Marcel-os/LWP/README.md

# Linefollower
Pliki związane z budową robota LF
