Marcel-os/LWP/schemat + pcb/PCB.png

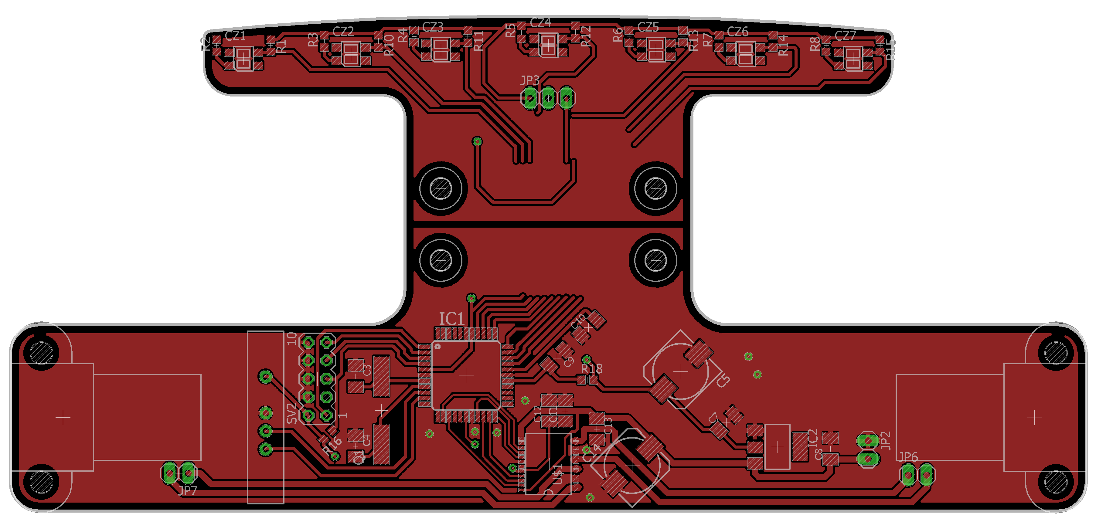
schemat + pcb/PCB.png
