Marcel-os/LWP/schemat + pcb/SCHEMAT.png

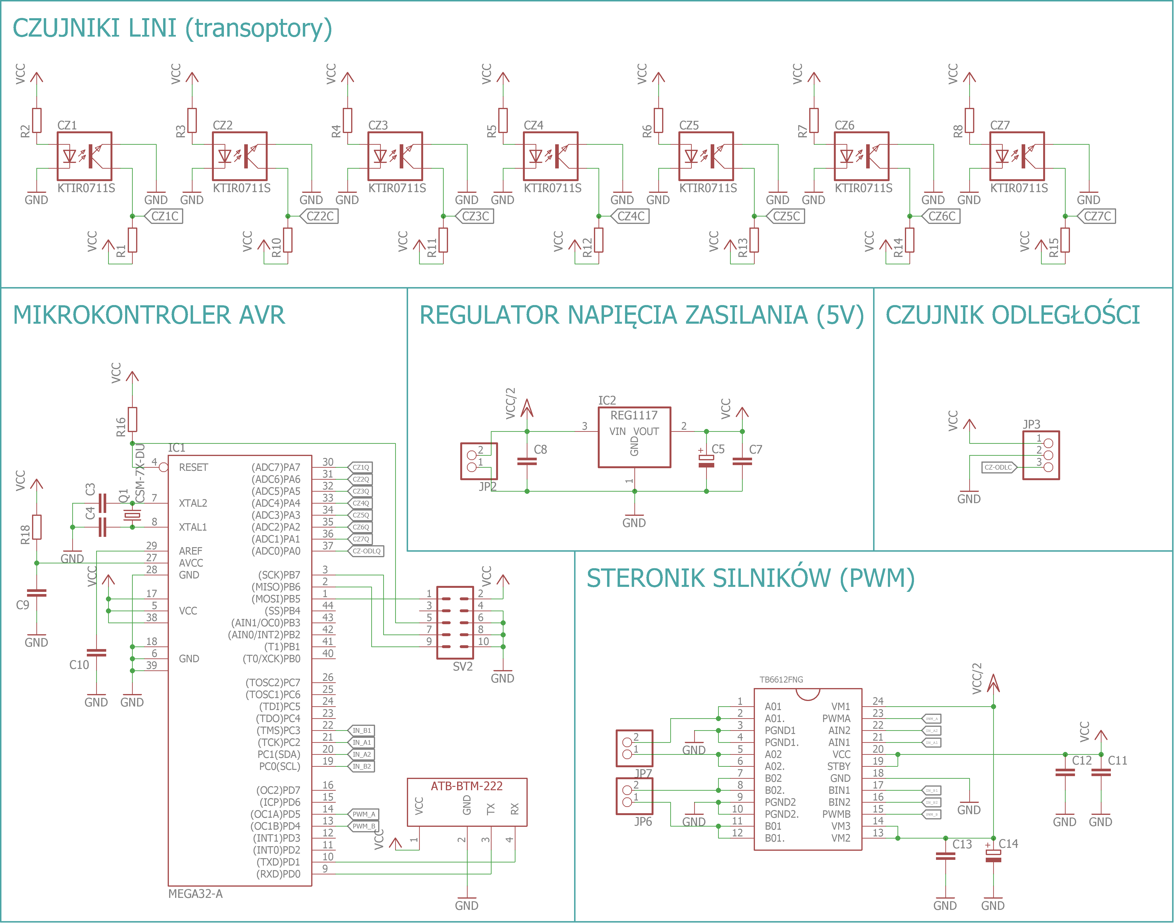
schemat + pcb/SCHEMAT.png
