Marcel-os/LWP/modele solid/kolo.SLDPRT

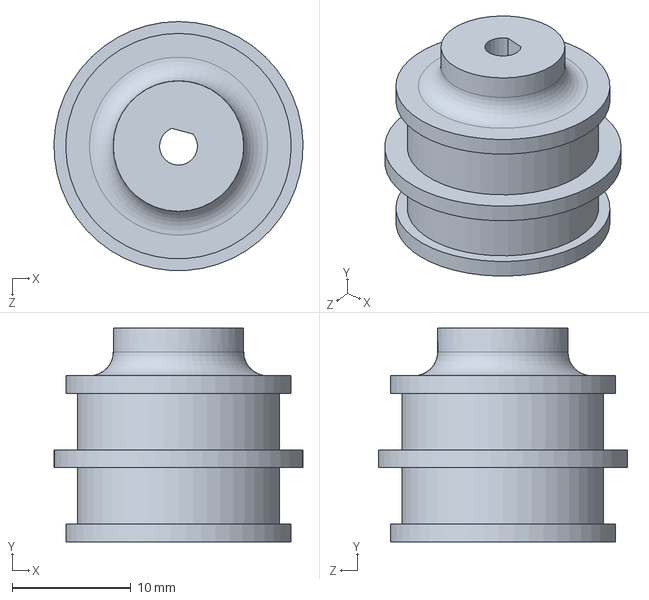
[picture p3: CAD file, 2020-06-14]
modele solid/kolo.SLDPRT
21.0 x 18.0 x 21.0 mm
