Marcel-os/LWP/modele stl/czesc.STL

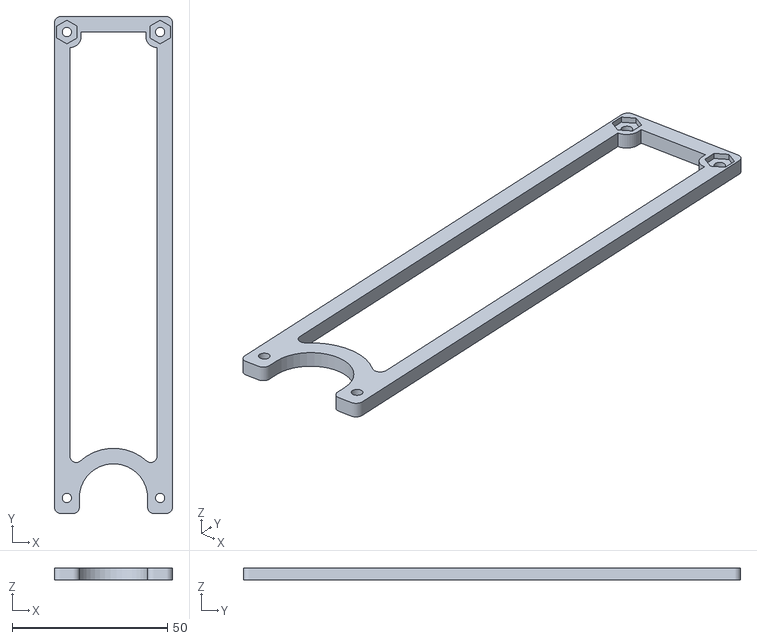
[picture p4: CAD file, 2020-06-14]
modele stl/czesc.STL
38.0 x 160.0 x 4.00
