Marcel-os/LWP/modele solid/lacznik2.SLDPRT

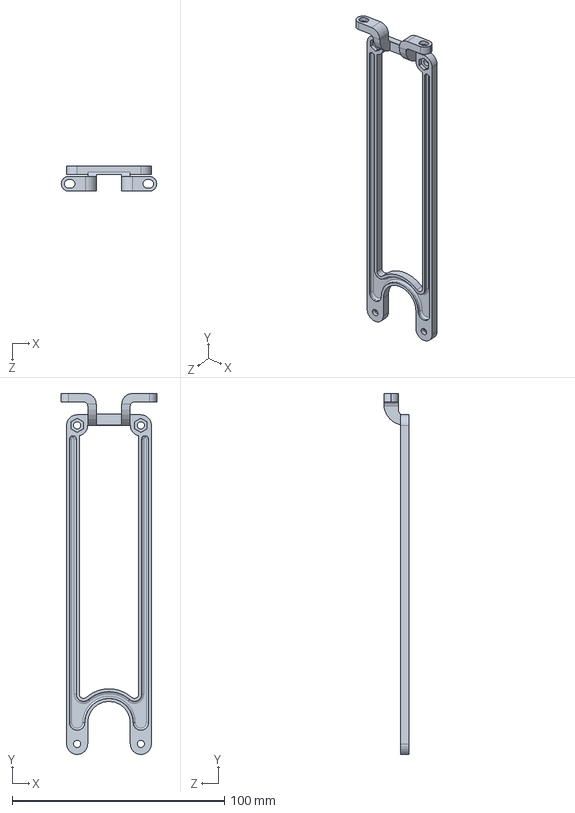
[picture p5: CAD file, 2020-06-14]
modele solid/lacznik2.SLDPRT
45.0 x 170.0 x 12.0 mm
