Marcel-os/LWP/modele stl/lf-hob.STL

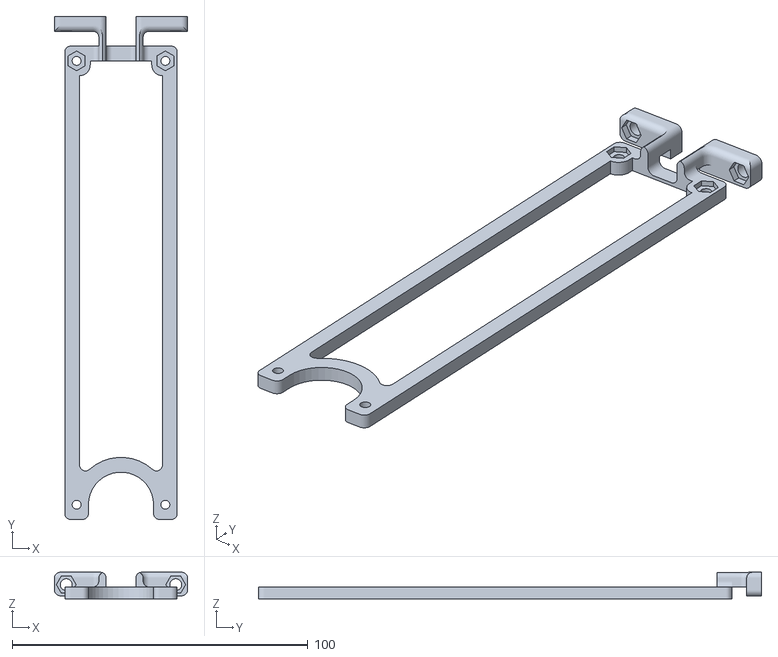
[picture p6: CAD file, 2020-06-14]
modele stl/lf-hob.STL
45.0 x 170.0 x 9.00
