Marcel-os/LWP/modele solid/czesc3.SLDPRT

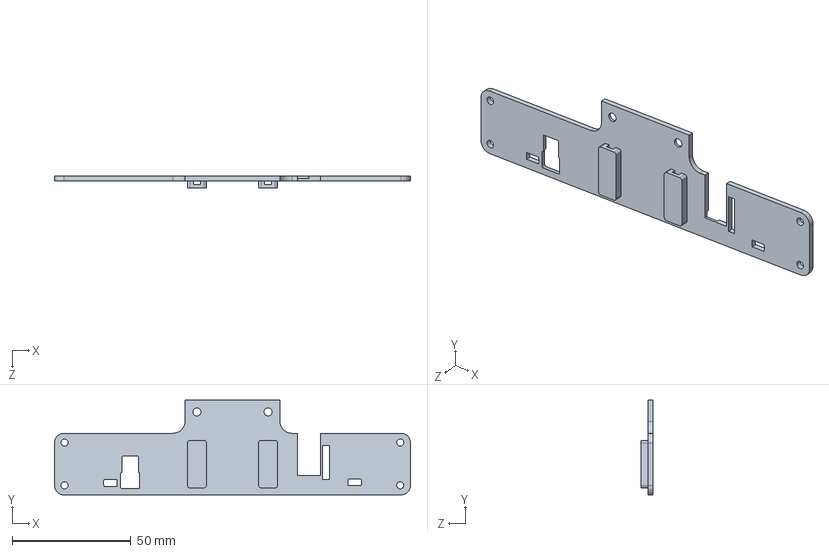
[picture p7: CAD file, 2020-06-14]
modele solid/czesc3.SLDPRT
150.0 x 40.0 x 5.00 mm
