Marcel-os/LWP/modele stl/proba1.STL

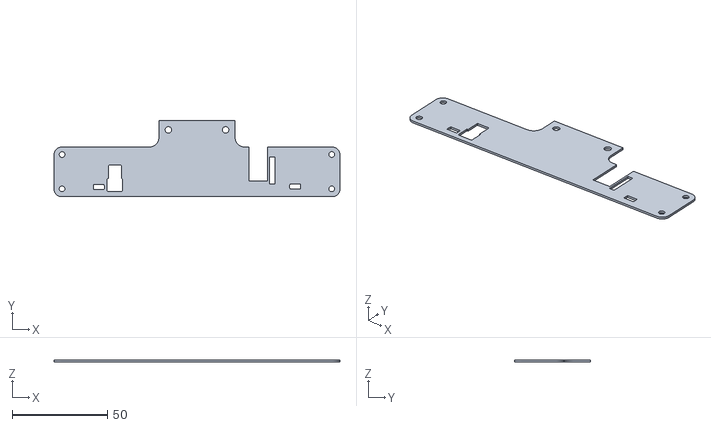
[picture p8: CAD file, 2020-06-14]
modele stl/proba1.STL
150.0 x 40.0 x 1.00
