Marcel-os/LWP/modele solid/PCB.dxf

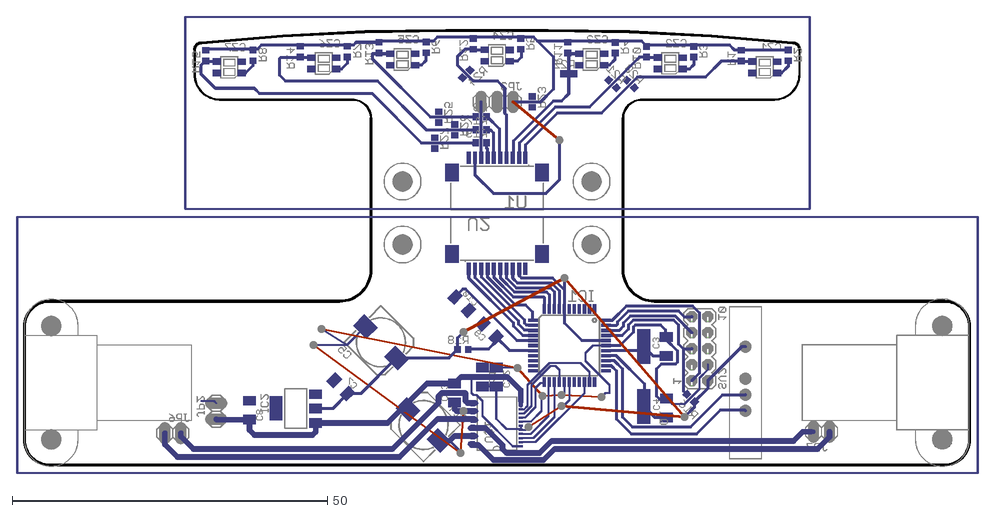
[picture p9: CAD file, 2020-06-14]
modele solid/PCB.dxf
152.7 x 72.7
