Marcel-os/LWP/(list of files, cad)

Other CAD files:
modele solid/czesc1.SLDPRT
