Marcel-os/LWP/schemat + pcb/untitled.brd

## EAGLE design schemat + pcb/untitled.brd (2020-04-21)

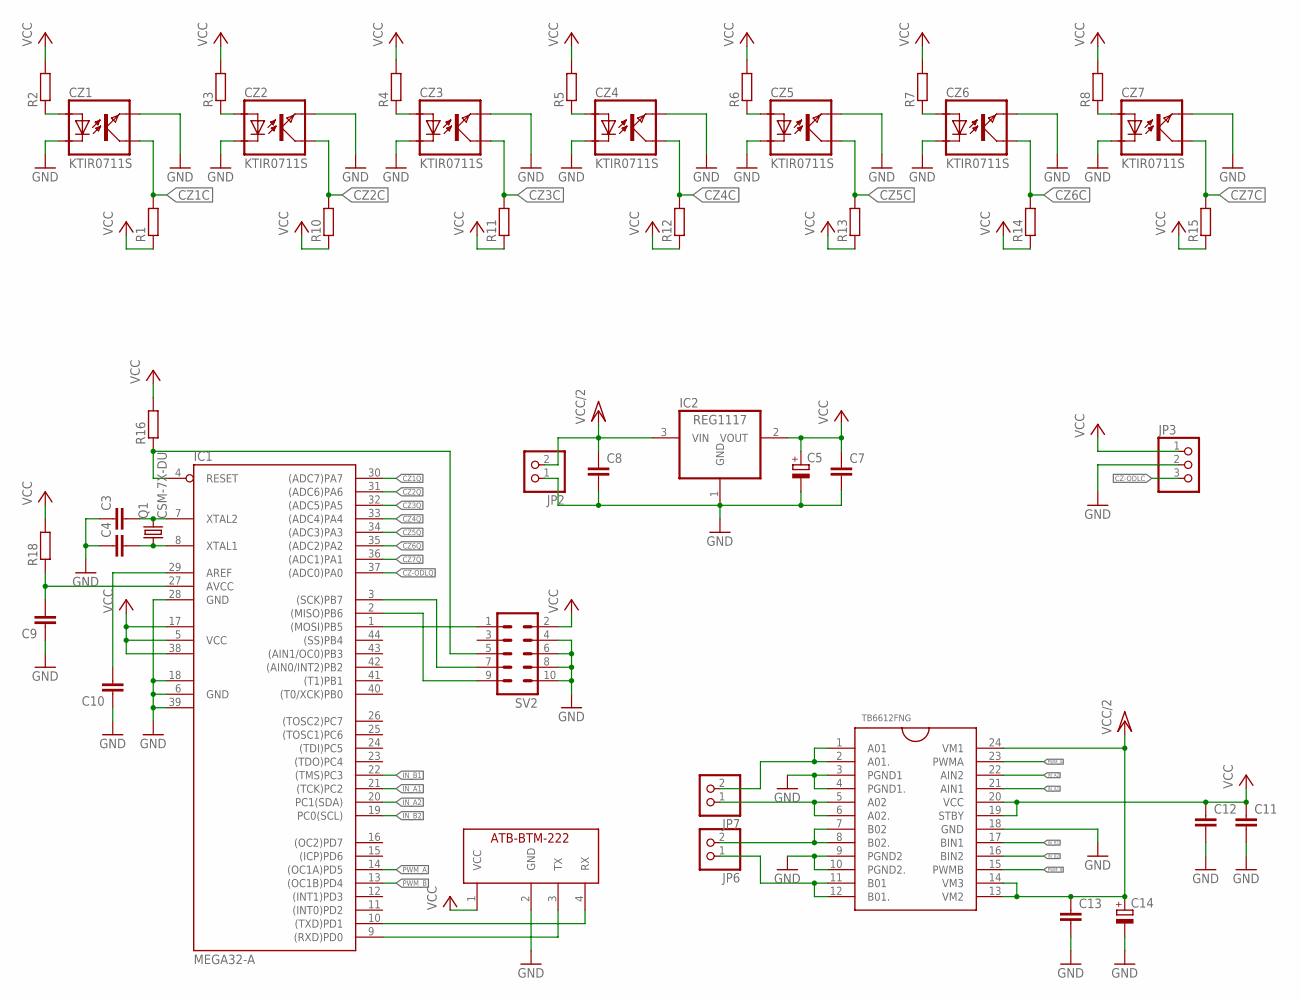
[picture p10: schematic untitled.sch]

Parts:
C3, C4, C7, C8, C9, C10, C11, C12, C13: C-EUC1206K; C1206K
C5, C14: CPOL-EU175TMP-0810; 175TMP-0810
CZ1, CZ2, CZ3, CZ4, CZ5, CZ6, CZ7: KTIR0711S; TOP
IC1: MEGA32-A; TQFP44
IC2: REG1117; SOT223
JP2, JP6, JP7: PINHD-1X2; 1X02
JP3: PINHD-1X3; 1X03
Q1: CSM-7X-DU
R1, R2, R3, R4, R5, R6, R7, R8, R10, R11, R12, R13, R14, R15, R16, R18: R-EU_R0603; R0603
SV2: MA05-2
U$1: TB6612FNG; SSOP24
U$2: ATB-BTM-222

Connections:
CZ1C: CZ1.KOLEKTOR, R1.2
CZ1Q: IC1.30 ((ADC7)PA7)
CZ2C: CZ2.KOLEKTOR, R10.2
CZ2Q: IC1.31 ((ADC6)PA6)
CZ3C: CZ3.KOLEKTOR, R11.2
CZ3Q: IC1.32 ((ADC5)PA5)
CZ4C: CZ4.KOLEKTOR, R12.2
CZ4Q: IC1.33 ((ADC4)PA4)
CZ5C: CZ5.KOLEKTOR, R13.2
CZ5Q: IC1.34 ((ADC3)PA3)
CZ6C: CZ6.KOLEKTOR, R14.2
CZ6Q: IC1.35 ((ADC2)PA2)
CZ7C: CZ7.KOLEKTOR, R15.2
CZ7Q: IC1.36 ((ADC1)PA1)
CZ-ODLC: JP3.3
CZ-ODLQ: IC1.37 ((ADC0)PA0)
GND: C3.1, C4.1, C5.-, C7.2, C8.2, C9.1, C10.1, C11.2, C12.2, C13.2, C14.-, CZ1.EMITER, CZ1.KATODA, CZ2.EMITER, CZ2.KATODA, CZ3.EMITER, CZ3.KATODA, CZ4.EMITER, CZ4.KATODA, CZ5.EMITER, CZ5.KATODA, CZ6.EMITER, CZ6.KATODA, CZ7.EMITER, CZ7.KATODA, IC1.6 (GND), IC1.18 (GND1), IC1.28 (GND), IC1.39 (GND2), IC2.1 (GND), JP2.1, JP3.2, SV2.4, SV2.6, SV2.8, SV2.10, U$1.3 (PGND1), U$1.4 (PGND1.), U$1.9 (PGND2), U$1.10 (PGND2.), U$1.18 (GND), U$2.2 (GND)
IN_A1: IC1.21 ((TCK)PC2), U$1.21 (AIN1)
IN_A2: IC1.20 (PC1(SDA)), U$1.22 (AIN2)
IN_B1: IC1.22 ((TMS)PC3), U$1.17 (BIN1)
IN_B2: IC1.19 (PC0(SCL)), U$1.16 (BIN2)
unnamed: IC1.10 ((TXD)PD1), U$2.4 (RX)
unnamed: IC1.9 ((RXD)PD0), U$2.3 (TX)
unnamed: C9.2, IC1.27 (AVCC), R18.1
unnamed: C10.2, IC1.29 (AREF)
unnamed: IC1.1 ((MOSI)PB5), SV2.1
unnamed: IC1.3 ((SCK)PB7), SV2.7
unnamed: IC1.2 ((MISO)PB6), SV2.9
unnamed: IC1.4 (RESET), R16.1, SV2.5
unnamed: C3.2, IC1.7 (XTAL2), Q1.2
unnamed: C4.2, IC1.8 (XTAL1), Q1.1
unnamed: CZ1.ANODA, R2.1
unnamed: CZ2.ANODA, R3.1
unnamed: JP6.2, U$1.7 (B02), U$1.8 (B02.)
unnamed: JP6.1, U$1.11 (B01), U$1.12 (B01.)
unnamed: JP7.1, U$1.5 (A02), U$1.6 (A02.)
unnamed: JP7.2, U$1.1 (A01), U$1.2 (A01.)
unnamed: CZ3.ANODA, R4.1
unnamed: CZ4.ANODA, R5.1
unnamed: CZ5.ANODA, R6.1
unnamed: CZ6.ANODA, R7.1
unnamed: CZ7.ANODA, R8.1
PWM_A: IC1.14 ((OC1A)PD5), U$1.23 (PWMA)
PWM_B: IC1.13 ((OC1B)PD4), U$1.15 (PWMB)
VCC: C5.+, C7.1, C11.1, C12.1, IC1.5 (VCC), IC1.17 (VCC1), IC1.38 (VCC2), IC2.2 (VOUT), JP3.1, R1.1, R2.2, R3.2, R4.2, R5.2, R6.2, R7.2, R8.2, R10.1, R11.1, R12.1, R13.1, R14.1, R15.1, R16.2, R18.2, SV2.2, U$1.19 (STBY), U$1.20 (VCC), U$2.1 (VCC)
VCC/2: C8.1, C13.1, C14.+, IC2.3 (VIN), JP2.2, U$1.13 (VM2), U$1.14 (VM3), U$1.24 (VM1)

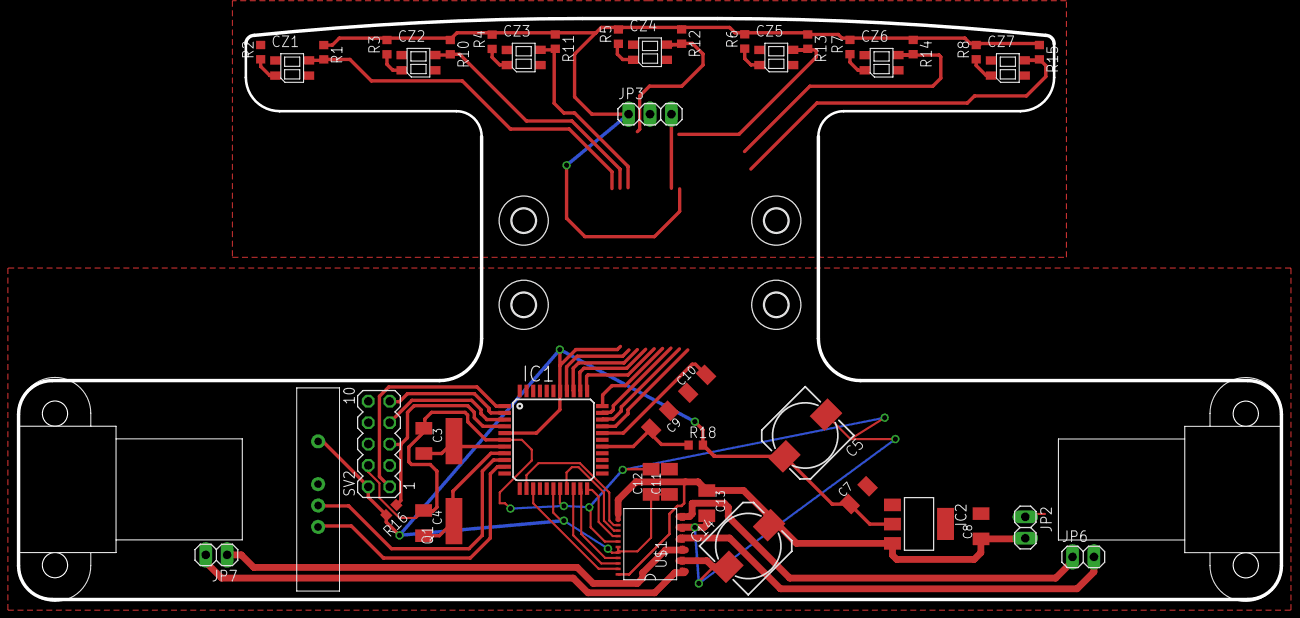
[picture p11: board untitled.brd from above]

Board: 2 copper layers, 150.0 x 69.0 mm, 50 parts (0 on the bottom side), 37 nets.

Other parts of the board:
U$3, U$6, U$7, U$8: 2,8
U$4, U$5: HP_NM
