Marcel-os/LWP/(commit log)

2020-04-21 Dodano schemat oraz pcb płytki robota
    [untitled.brd, untitled.sch]
2020-04-23 Dodanie modelu uchwytu silnika
    [motor-holder.STL]
2020-04-23 Dodanie modeli solidworks
    [PCB.dxf, czesc.STL, czesc1.SLDPRT, czesc3.SLDPRT, kolo.SLDPRT, lacznik2.SLDPRT, lf-hob.STL, motor-holder.SLDPRT]
2020-06-14 Dodano regulator PD jazdy po lini
